feixingzhe9/bestfu-dev-cube/280.IS6001-智能魔方/文档/IS6001-动作感知魔方-资源属性列表V1.0.docx

魔方六面体资源属性列表

# 变更记录

版本号 | 修改原因／内容 | 修改人 | 审核／ 批准人 | 修改时间
V1.0 | 创建 | 李偌淮 | | 2014.8.21

工作流 | 责任人签字 | 完成日期 | 完成总时间
属性文档准备
主机实现
APP实现
设备功能APP确认
测试

# 目 录

## 1.1 六面体面值属性 [0x01][R]

概述：六面体向上面面值属性。

代码：0x01

权限：读

### 1.1.1 查询[Read]

发送(Request):

参数区 | 参数1
内容 | 无
长度 | 0 byte
说明
备注

应答(Response):

参数区 | 参数1 | 参数2
内容 | 状态标志 | 面值
长度 | 1byte | 1byte
说明 | - 0x01成功 - 0x00失败 | - 0 空值（保留） - 1-6 面值
备注

## 1.2 电池电量属性 [0xC8][R]

概述：查询电池剩余电量。

代码：0XC8

权限：读

### 1.2.1 查询[Read]

发送(Request):

参数区 | 参数1
内容 | 无
长度 | 0 byte
说明
备注

应答(Response):

参数区 | 参数1 | 参数2
内容 | 状态标志 | 剩余电量
长度 | 1byte | 1byte
说明 | - 0x01成功 - 0x00失败 | - 0 读取电量失败 - 1-100 剩余电量1%-100%
备注

## 附录

在安卓普通界面上显示属性为：

六面体面值属性[0x01]，电池电量属性[0xC8]

在安卓高级配置界面中显示属性为：

普通界面与高级配置界面，两者不要共同存在一个界面上。

## 可配置场景属性

无

## 可配置为联动目标属性

无

## 可配置为联动源属性

面值属性[0x01]
