feixingzhe9/bestfu-dev-cube/280.IS6001-智能魔方/Trunk/BootLoader_1_Library/Documentation/上位机烧录文件制作说明.pdf

# 上位机烧录文件制作说明

# 64K flash 芯片需要修改的示意图：

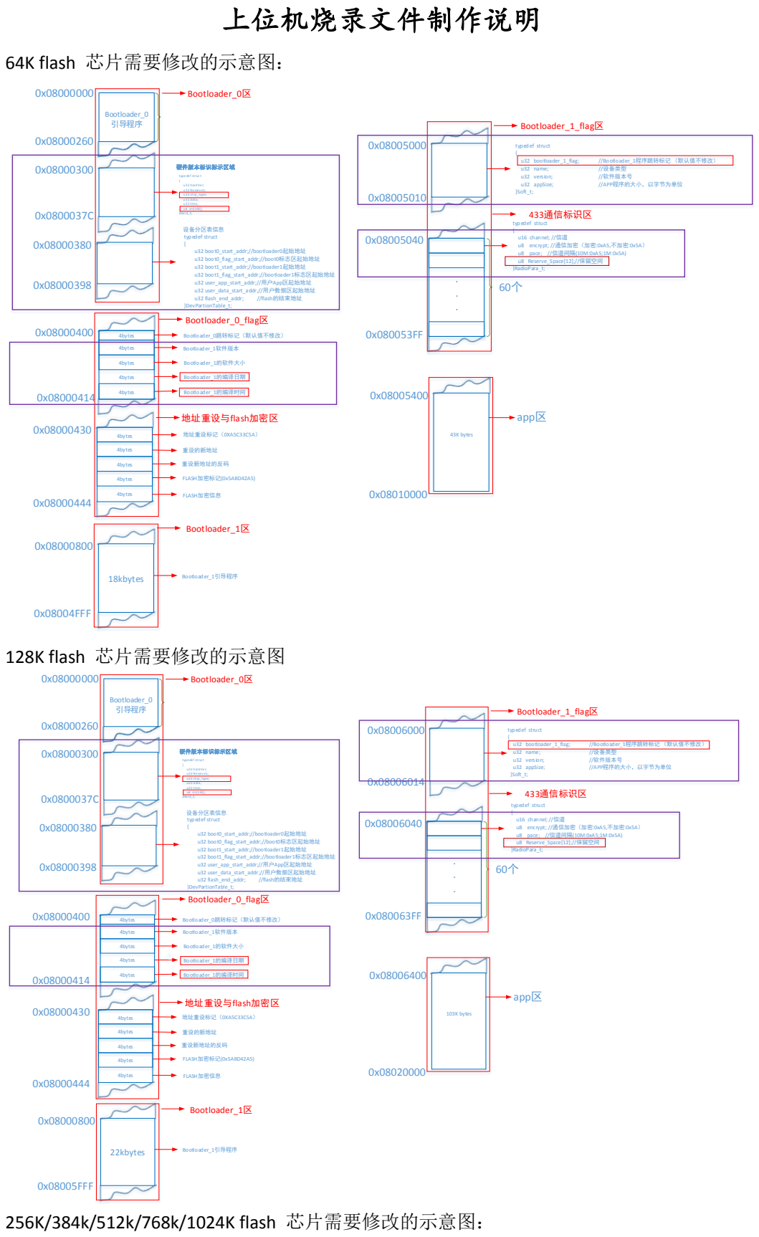
[picture p3: page 1]

0x08000000 | Bootloader_0区

硬件版本标识标示区域

0x08000260

0x08000300

0x0800037C

0x08000400 | 4bytes | Bootloader_0跳转标记（默认值不修改）
| 4bytes
| 4bytes | Bootloader_1软件版本
| | Bootloader_1的软件大小
4bytes | Bootloader_1的编译时间 | 0x08005400

# app区

43K bytes

4bytes | Bootloader_1的编译日期
0x08005000 | typedef struct

{
u32 bootloader_1_flag; | //Bootloader_1程序跳转标记 （默认值不修改）
u32 name; | //设备类型
u32 version; | //软件版本号
u32 appSize; | //APP程序的大小，以字节为单位
}Soft_t;
0x08005010

0x08005040

# 0x080053FF

60个

0x08000800

18kbytes | Bootloader_1引导程序

0x08000414

## Bootloader_0 引导程序

## Bootloader_0_flag区

# 0x08004FFF

## Bootloader_1区

## Bootloader_1_flag区

0x08010000

0x08000430
4bytes | 地址重设标记（0XA5C33C5A）
| 重设的新地址
| 重设新地址的反码

0x08000444

4bytes

4bytes

4bytes

4bytes

FLASH加密标记(0x5ABD42A5)

FLASH加密信息

typedef struct
{
u16 channel; //信道
u8 encrypt; //通信加密（加密:0xA5,不加密:0x5A） u8 pace; //信道间隔(10M:0xA5;1M:0x5A)
u8 Reserve_Space[12];//保留空间 }RadioPara_t;

typedef struc t
{
u32 hardVer;
u32 Reserv e1;
u32 chip_type;
u32 data;
u32 time;
u8 str[100];
}Ha rd_t;

设备分区表信息
0x08000380

0x08000398

typedef struct
{
u32 boot0_start_addr;//bootloader0起始地址
u32 boot0_flag_start_addr;//boot0标志区起始地址 u32 boot1_start_addr;//bootloader1起始地址
u32 boot1_flag_start_addr;//bootloader1标志区起始地址 u32 user_app_start_addr;//用户App区起始地址
u32 user_data_start_addr;//用户数据区起始地址
u32 flash_end_addr; //flash的结束地址 }DevPartionTable_t;

# 地址重设与flash加密区

# 433通信标识区

# 128K flash 芯片需要修改的示意图

0x08006400

# app区

103K bytes

0x08006000

0x08006014

0x08006040

# 0x080063FF

60个

0x08000800

22kbytes | Bootloader_1引导程序

# 0x08005FFF

## Bootloader_1区

## Bootloader_1_flag区

0x08020000

0x08000400 | 4bytes | Bootloader_0跳转标记（默认值不修改）
| 4bytes
| 4bytes | Bootloader_1软件版本
| | Bootloader_1的软件大小
4bytes | Bootloader_1的编译时间
4bytes | Bootloader_1的编译日期
0x08000414

## Bootloader_0_flag区

0x08000430
4bytes

重设的新地址

重设新地址的反码

FLASH加密标记(0x5ABD42A5)

0x08000444

4bytes

4bytes

4bytes

4bytes | FLASH加密信息

地址重设标记（0XA5C33C5A）

typedef struct
{
u32 bootloader_1_flag; | //Bootloader_1程序跳转标记 （默认值不修改）
u32 name; | //设备类型
u32 version; | //软件版本号
u32 appSize; | //APP程序的大小，以字节为单位
}Soft_t;

0

typedef struct
{
u16 channel; //信道
u8 encrypt; //通信加密（加密:0xA5,不加密:0x5A） u8 pace; //信道间隔(10M:0xA5;1M:0x5A)
u8 Reserve_Space[12];//保留空间 }RadioPara_t;
0x08000000 | Bootloader_0区

硬件版本标识标示区域

0x08000260

0x08000300

0x0800037C

## Bootloader_0 引导程序

typedef struc t
{
u32 hardVer;
u32 Reserv e1;
u32 chip_type;
u32 data;
u32 time;
u8 str[100];
}Ha rd_t;

设备分区表信息
0x08000380

0x08000398

typedef struct
{
u32 boot0_start_addr;//bootloader0起始地址
u32 boot0_flag_start_addr;//boot0标志区起始地址 u32 boot1_start_addr;//bootloader1起始地址
u32 boot1_flag_start_addr;//bootloader1标志区起始地址 u32 user_app_start_addr;//用户App区起始地址
u32 user_data_start_addr;//用户数据区起始地址
u32 flash_end_addr; //flash的结束地址 }DevPartionTable_t;

## 地址重设与flash加密区

## 433通信标识区

# 256K/384k/512k/768k/1024K flash 芯片需要修改的示意图：

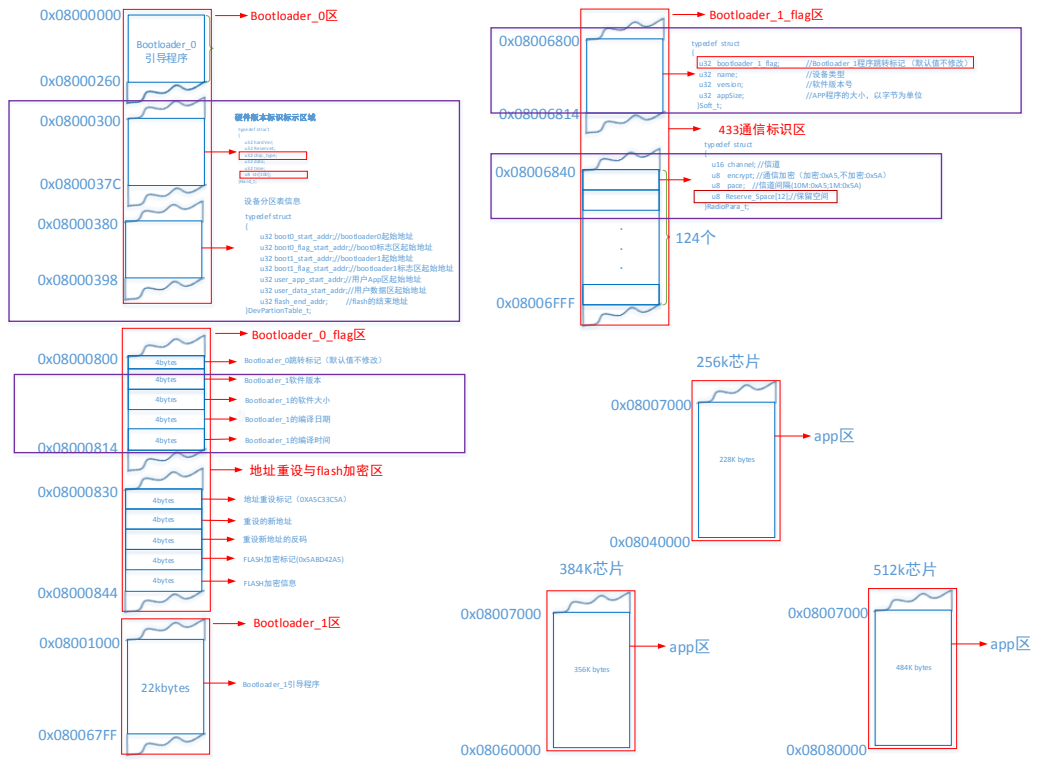
[picture p4: figure]
0x08006FFF; 22kbytes; Bootloader_1引导程序; Bootloader_1区; Bootloader_1_flag区; 4bytes; Bootloader_1软件版本; Bootloader_1的软件大小; Bootloader_1的编译时间; Bootloader_1的编译日期; Bootloader_0_flag区; 地址重设标记（0XA5C33C5A）; 重设的新地址; 重设新地址的反码; FLASH加密标记(0x5ABD42A5); FLASH加密信息; Bootloader_0跳转标记（默认值不修改）; typedef struct {; u32 bootloader_1_flag;; //Bootloader_1程序跳转标记 （默认值不修改）; u32 name;; //设备类型; u32 version;; //软件版本号; u32 appSize;; //APP程序的大小，以字节为单位; }Soft_t;; u16 channel; //信道 u8 encrypt; //通信加密（加密:0xA5,不加密:0x5A） u8 pace; //信道间隔(10M:0xA5;1M:0x5A) u8 Reserve_Space[12];//保留空间 }RadioPara_t;; app区; 228K bytes; 256k芯片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

# 说明：①、上图中，紫色方框标识需要修改的地方； ②、例如根据不同的需求，需要向烧录芯片写入不同的烧录值，加密、信道、信道间隔、芯 片类型的信息；
