feixingzhe9/bestfu-dev-cube/280.IS6001-智能魔方/硬件/IS6001_main V1.4.2.pdf

D

6 | 5 | 4 | 3 | 2 | 1

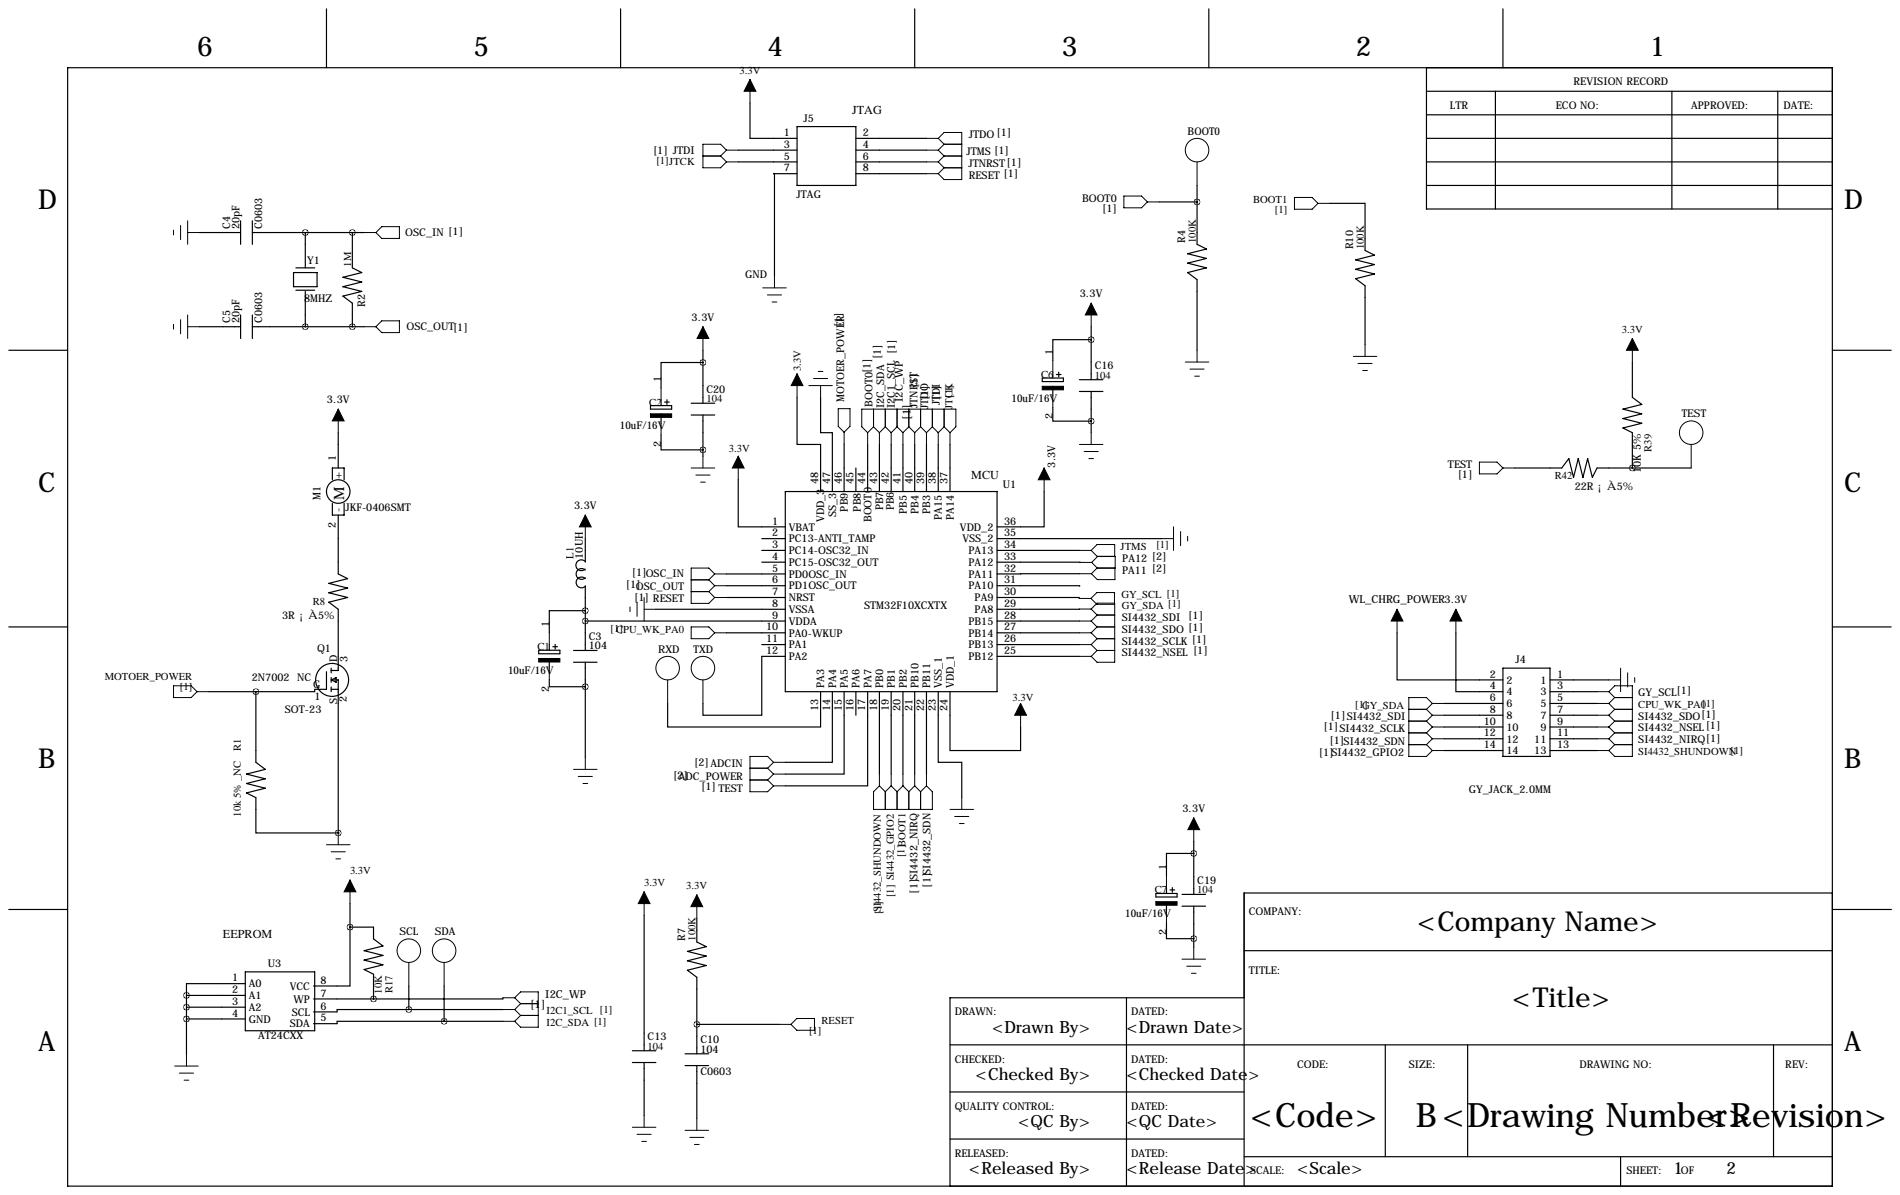
[picture p7: page 1]

3.3V | REVISION RECORD

LTR | ECO NO: | APPROVED: | DATE:

CHECKED: <Checked By> | DATED: <Checked Date> | CODE: | SIZE: | DRAWING NO: | REV:

QUALITY CONTROL: <QC By> | DATED: <QC Date>

RELEASED: <Released By> | DATED:

<Scale> SCALE: | 1 2 SHEET: OF

D

6 | 5 | 4 | 3 | 2 | 1

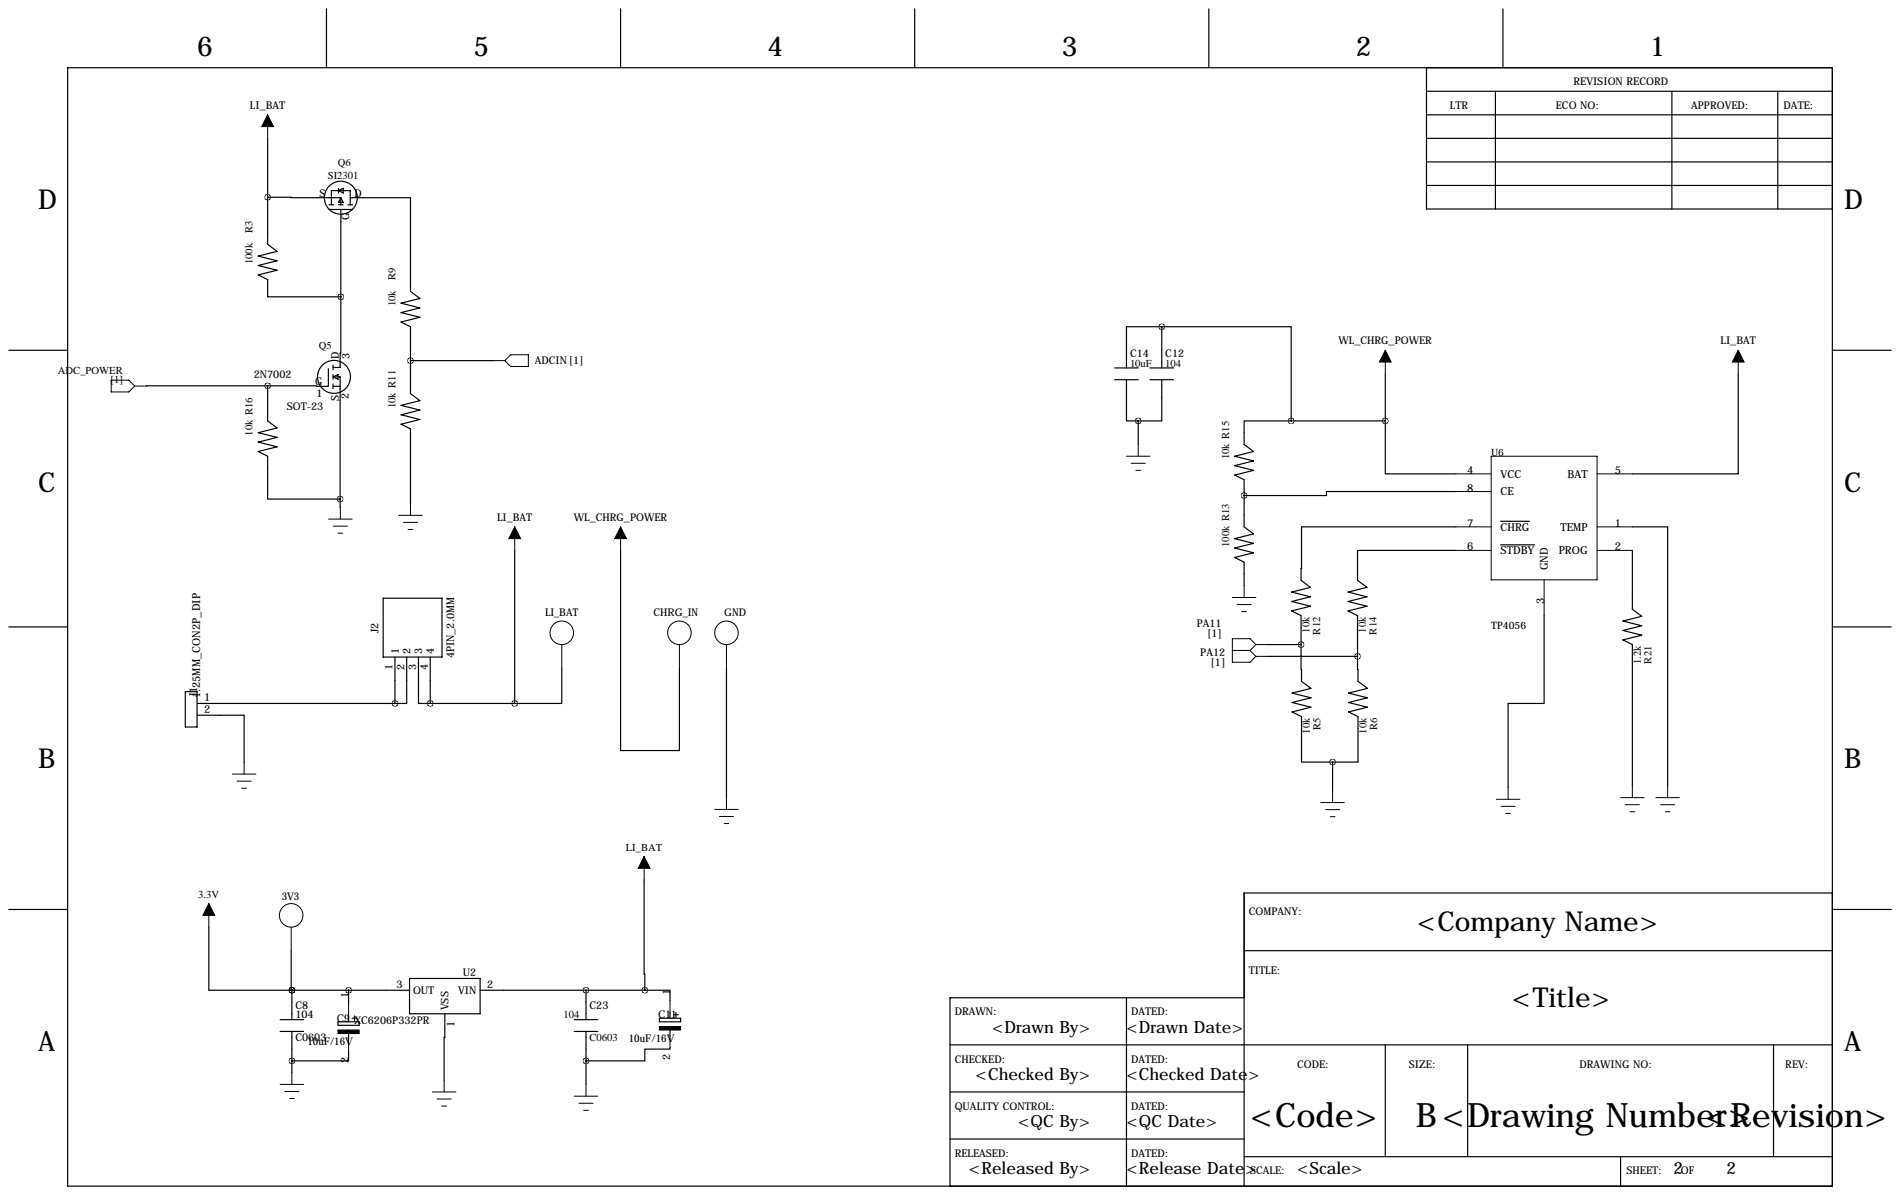
[picture p8: page 2]

LI_BAT | REVISION RECORD

LTR | ECO NO: | APPROVED: | DATE:

DRAWN: <Drawn By> | DATED: <Drawn Date>

CHECKED: <Checked By> | DATED: <Checked Date> | CODE: | SIZE: | DRAWING NO: | REV:

QUALITY CONTROL: <QC By> | DATED: <QC Date>

RELEASED: <Released By> | DATED:

<Scale> SCALE: | 2 2 SHEET: OF
