feixingzhe9/bestfu-dev-cube/280.IS6001-智能魔方/Branches/Transition Upgrade package SRC/SRC_64K/Cube6_V2.05.02/Lib_code/SysPower/BatteryExeAttr.h

/***************************Copyright BestFu ***********************************
**  文    件：  BatteryExeAttr.h
**  功    能：  <<属性层>> 电池属性接口 
**  编    译：  Keil uVision5 V5.10
**  版    本：  V1.0
**  编    写：  Seven
**  创建日期：  2014.08.20
**  修改日期：  2014.08.20
**  说    明：  
**  V1.0
    >>
*******************************************************************************/
#ifndef _BATTERY_EXE_ATTR_H_
#define _BATTERY_EXE_ATTR_H_

#include "BF_TYPE.h"
#include "UnitCfg.h"

#define CHRG_PORT	GPIO_A
#define CHRG_PIN	pin_11

#define STDBY_PORT	GPIO_A
#define STDBY_PIN	pin_12


extern void Battery_Init(void);
extern MsgResult_t Get_PowerPercent_Attr(UnitPara_t *pData, u8 *rlen, u8 *rpara);
extern MsgResult_t Get_ChargeState_Attr(UnitPara_t *pData, u8 *rlen, u8 *rpara);

#endif
/***************************Copyright BestFu **********************************/
