feixingzhe9/bestfu-dev-cube/280.IS6001-智能魔方/Trunk/BootLoader_1_Library/BootLoader Source/STM32L15x_Medium/SysHard/include/SysHard.h

/***************************Copyright BestFu 2014-05-14*************************
文	件：    SysHard.h
说	明：    系统硬件相关函数
编	译：    Keil uVision4 V4.54.0.0
版	本：    v2.0
编	写：    Unarty
日	期：    2014.06.26
修　改：	暂无
*******************************************************************************/
#ifndef __SYSHARD_H
#define __SYSHARD_H

/*********************************自定义宏*************************************/
#define STATUS0(GPIOx, pin)  GPIO_ResetBits(GPIOx, pin)	//相应管脚置0
#define STATUS1(GPIOx, pin)  GPIO_SetBits(GPIOx, pin)  //相应管脚置1 
#define STATUS_(GPIOx, pin)  GPIO_ToggleBits(GPIOx, pin) //相应管脚取反

//EEPROM IIC通信接口
#define SCL_PORT    		GPIO_B      //SCL端口
#define SCL_PIN    			GPIO_Pin_6  //SCL引脚 
													    
#define SDA_PORT    		GPIO_B      //SDA端口
#define SDA_PIN     		GPIO_Pin_7  //SDA引脚

#define EEPROM_WP			(1) 		//EEPROM写保护。 1: 有写使能保护管脚，0：无写使能保护管脚

#if EEPROM_WP
	#define WP_PORT			GPIO_B		//Write Protect port
	#define WP_PIN			GPIO_Pin_5	//Write Protect pin
#endif 


//进入测试模式按键
#define TEST_KEY_PORT 		GPIO_C
#define TEST_KEY_PIN  		GPIO_Pin_15
#define TEST_VALID_LEVEL	(0)			//有效电平
#if TEST_VALID_LEVEL == 1
	#define TEST_KEY_INIT 	GPIO_Config(TEST_KEY_PORT, TEST_KEY_PIN, IN_DOWN);
	#define TEST_KEY_VAL	(1)//(GPIO_ReadInputDataBit(TEST_KEY_PORT, TEST_KEY_PIN))
#else
	#define TEST_KEY_INIT 	GPIO_Config(TEST_KEY_PORT, TEST_KEY_PIN, IN_UP);
	#define TEST_KEY_VAL	(1)//(GPIO_ReadInputDataBit(TEST_KEY_PORT, TEST_KEY_PIN))
#endif


//用户数据重置端口定义 : 注意内部检测，RESET_KEY_VAL 返回：零有效， 非零无效
#define RESET_USER_DATA			(1)   //1：开启重置用户数据按钮。0：关闭重置用户数据按钮
#if RESET_USER_DATA
	#define RESET_KEY_PORT 		GPIO_C
	#define RESET_KEY_PIN  		GPIO_Pin_13
	#define RESET_VALID_LEVEL	(0)		//有效电平
	#if (RESET_VALID_LEVEL == 1)
		#define RESET_KEY_INIT 	GPIO_Config(RESET_KEY_PORT, RESET_KEY_PIN, IN_DOWN);							
		#define RESET_KEY_VAL	(GPIO_ReadInputDataBit(RESET_KEY_PORT, RESET_KEY_PIN))
	#else
		#define RESET_KEY_INIT 	GPIO_Config(RESET_KEY_PORT, RESET_KEY_PIN, IN_UP);					
		#define RESET_KEY_VAL	(GPIO_ReadInputDataBit(RESET_KEY_PORT, RESET_KEY_PIN))
	#endif
#endif


//系统运行指示灯端口
#define RUN_INSTRUCT		(0)   //1：开启运行指示。0：关闭运行指示
#if RUN_INSTRUCT
	#define RUN_PORT		GPIO_A    
	#define RUN_PIN			GPIO_Pin_2
	#define RUN_ON			STATUS0(RUN_PORT, RUN_PIN)
	#define RUN_OFF			STATUS1(RUN_PORT, RUN_PIN)
#endif

//内部看门狗配置
#define INTERNAL_IWDG_EN	(1u)		//1:开启内部看门狗;0：关闭内部看门狗

//外部看门狗端口
#define EXTERNAL_WDG_EN		(1u) 		//1：开启外部看门狗。0：不产生外部喂狗
#if (EXTERNAL_WDG_EN > 0u)
	#define	WDG_PORT		GPIO_A			//硬件喂狗端口
	#define WDG_PIN			GPIO_Pin_12		//硬件喂狗引脚
#endif

//433 通信接口
#define nGPIO2_PORT     	GPIO_B			//通信忙反馈端口
#define nGPIO2_PIN      	GPIO_Pin_1 		//通信忙反馈引脚

#define SDN_PORT        	GPIO_B			//433复位端口
#define SDN_PIN         	GPIO_Pin_11		//433复位引脚

#define nIRQ_PORT       	GPIO_B  		//数据中断端口  注意：中断IO修改后需要修改内部的一些配置
#define nIRQ_PIN        	GPIO_Pin_10		//数据中断引脚

#define nSEL_PORT       	GPIO_B  		//SPI片选端口
#define nSEL_PIN        	GPIO_Pin_12		//SPI片选引脚

#define RF_SWITCH			(1)				//无线电源开关 1:(无线有电源开关), 0(无线没有开关)
#if RF_SWITCH
#define RF_SWITCH_PORT		GPIO_B			//无线电源开关端口
#define RF_SWITCH_PIN		GPIO_Pin_0		//无线电源开关引脚
#define RF_SWITCH_ON		STATUS1(RF_SWITCH_PORT, RF_SWITCH_PIN)	//无线电源开
#define RF_SWITCH_OFF		STATUS0(RF_SWITCH_PORT, RF_SWITCH_PIN)	//无线电源关
#endif

#define SI4432_CH			(0)				//定义433无线信道: 86 / 85 / 84 / 83 / 82 / 81 //其他就使用其软件设置值
#if (SI4432_CH < 81 || SI4432_CH > 86)
	#undef SI4432_CH
#endif

#define SI4432_THRESHOLD 	(0)	//定义433无线信道门槛（Threshold）: 60 ～ 220. （注意 ：0 使用设备自动门槛设置）
#if (SI4432_THRESHOLD == 0)
	#undef SI4432_THRESHOLD 
#endif

//433无线信号指示端口*/
#define SIGNAL				(0)		//是否需要信号指示功能 1: 需要， 0：不需要
#define SIGNAL_PORT	GPIO_A
#define SIGNAL_PIN	GPIO_Pin_11
#define SIGNAL_ON	STATUS0(RUN_PORT, RUN_PIN)
#define SIGNAL_OFF	STATUS1(RUN_PORT, RUN_PIN)

/***********************************函数声明***********************************/
void SysHard_Init(void);
BF_INT32U HardID_Check(BF_INT32U id);
#if (DEVICE_ADDR_RESET_FEATURE_EN > 0u)
void HardID_Change(void);
#endif

#endif 		//SysHard.h end 
/**************************Copyright BestFu 2014-05-14*************************/
